nguyendochienthang711-ai/Robot_Teo_AI_mini/cad_3d_stl/backup_v9/teo_than_duoi.stl

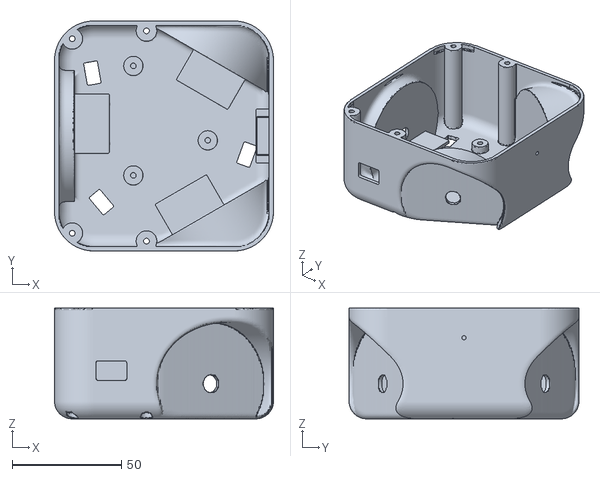
[picture p1: CAD file, 2026-11-09]
cad_3d_stl/backup_v9/teo_than_duoi.stl
100.0 x 105.0 x 50.5
