nguyendochienthang711-ai/Robot_Teo_AI_mini/cad_3d_stl/step/teo_mu_dau.step

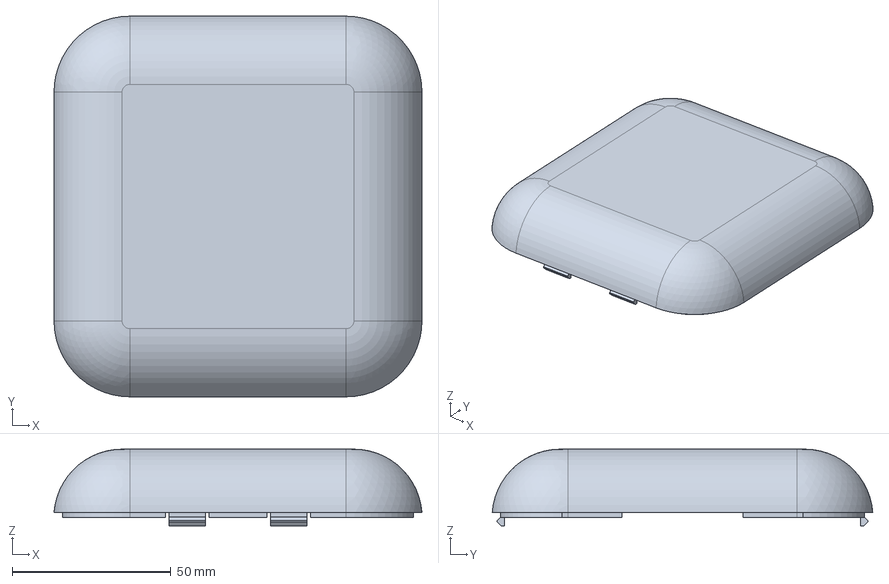
[picture p2: CAD file, 2026-11-14]
cad_3d_stl/step/teo_mu_dau.step
115.9 x 119.9 x 24.2 mm
