nguyendochienthang711-ai/Robot_Teo_AI_mini/cad_3d_stl/teo_tong_the_orca.3mf

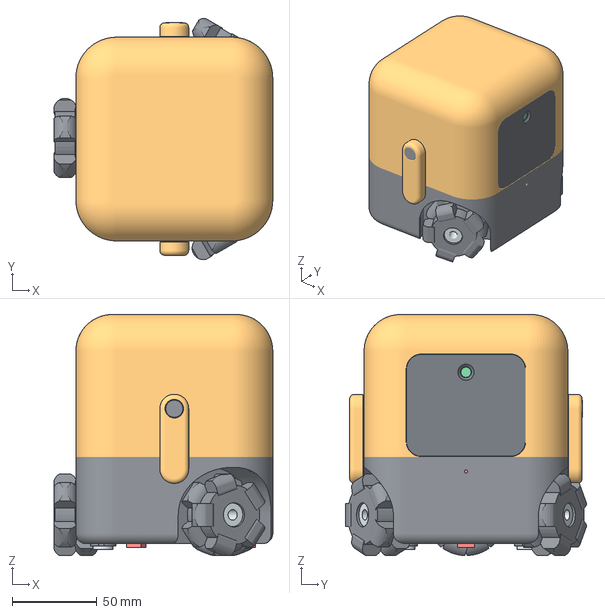
[picture p3: CAD file, 2026-11-14]
cad_3d_stl/teo_tong_the_orca.3mf
128.8 x 142.2 x 142.0 mm
