nguyendochienthang711-ai/Robot_Teo_AI_mini/cad_3d_stl/backup_v9/teo_kinh_sla.stl

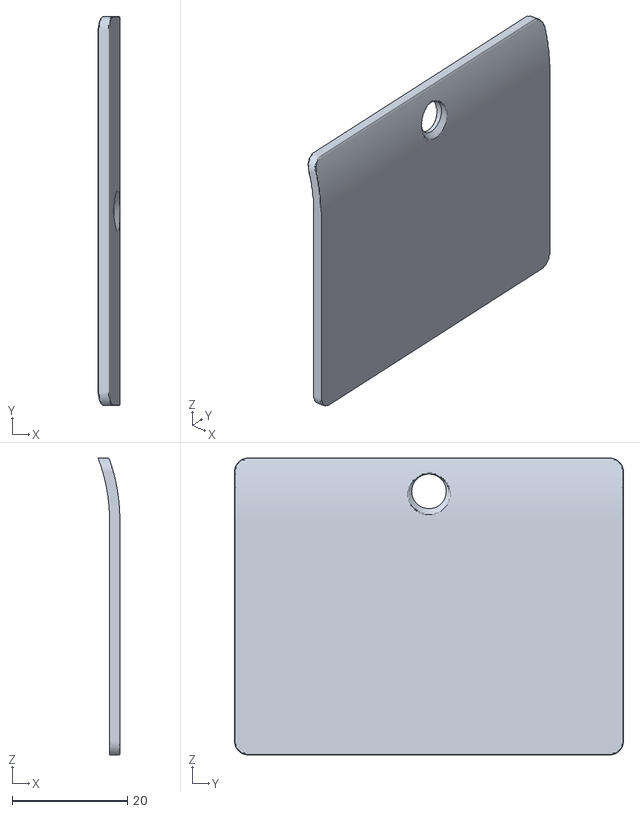
[picture p4: CAD file, 2026-11-09]
cad_3d_stl/backup_v9/teo_kinh_sla.stl
3.78 x 67.6 x 51.6
