nguyendochienthang711-ai/Robot_Teo_AI_mini/cad_3d_stl/step/teo_than_duoi.step

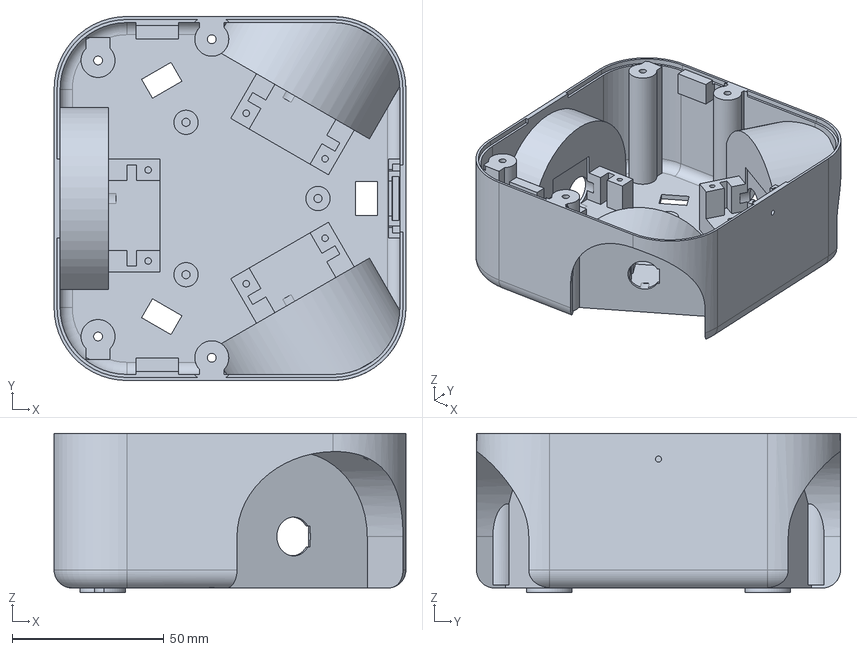
[picture p5: CAD file, 2026-11-14]
cad_3d_stl/step/teo_than_duoi.step
116.0 x 120.0 x 52.5 mm
