nguyendochienthang711-ai/Robot_Teo_AI_mini/cad_3d_stl/teo_tong_the_xuyen_thau_orca.3mf

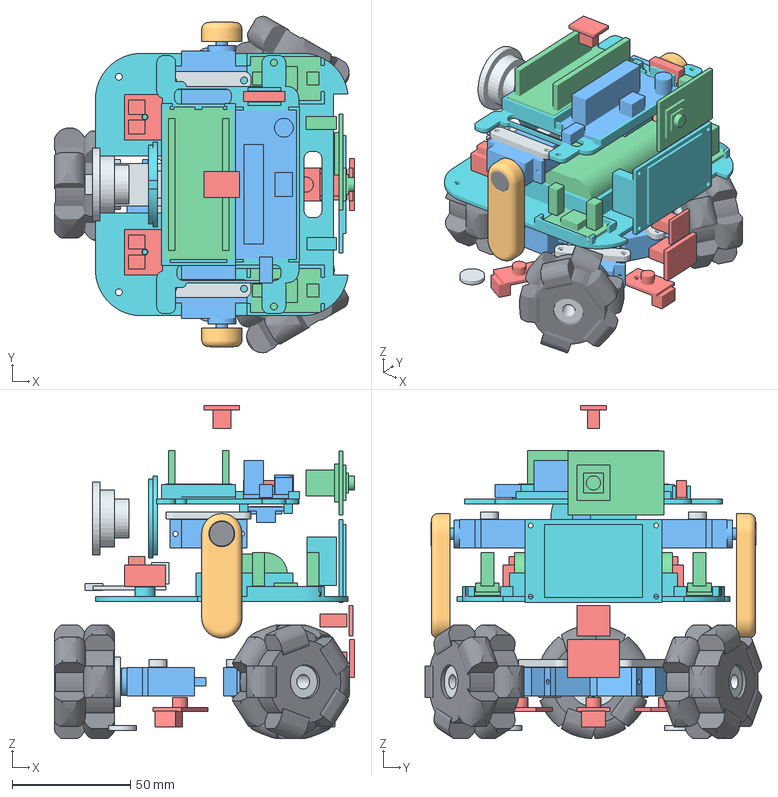
[picture p6: CAD file, 2026-11-14]
cad_3d_stl/teo_tong_the_xuyen_thau_orca.3mf
126.8 x 142.2 x 140.7 mm
