nguyendochienthang711-ai/Robot_Teo_AI_mini/cad_3d_stl/backup_v9/teo_vach_ngan.stl

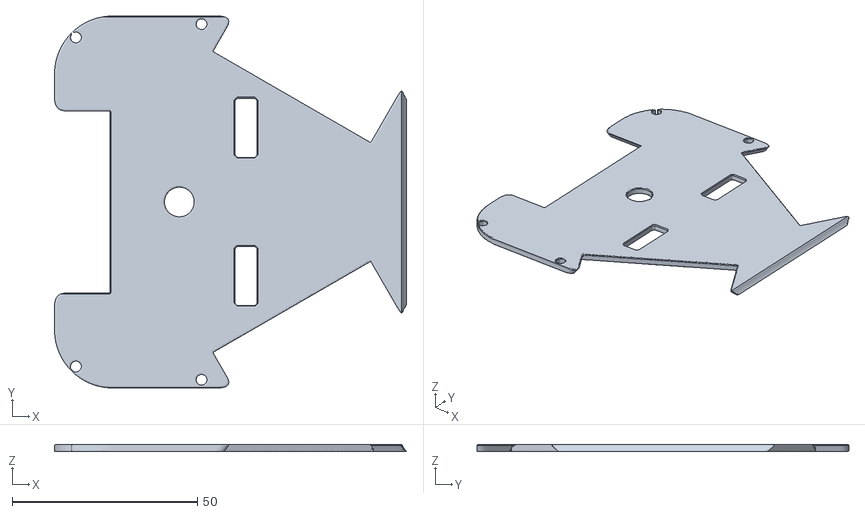
[picture p7: CAD file, 2026-11-09]
cad_3d_stl/backup_v9/teo_vach_ngan.stl
95.0 x 100.4 x 2.00
