nguyendochienthang711-ai/Robot_Teo_AI_mini/cad_3d_stl/step/teo_vach_ngan.step

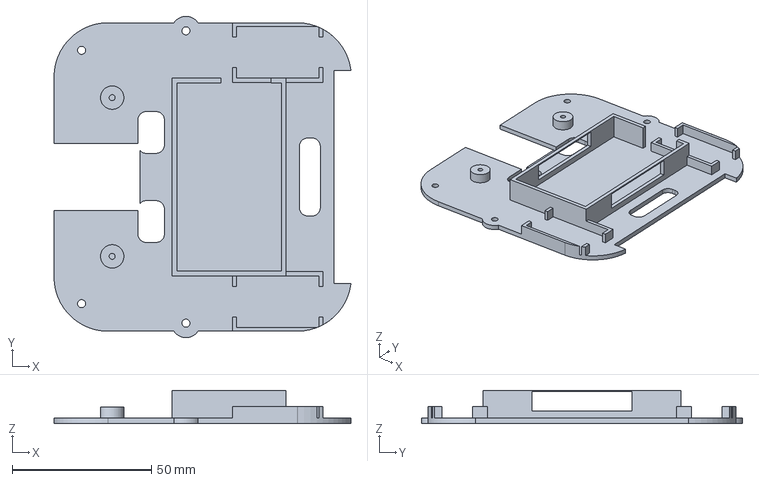
[picture p8: CAD file, 2026-11-14]
cad_3d_stl/step/teo_vach_ngan.step
106.7 x 115.4 x 12.0 mm
