nguyendochienthang711-ai/Robot_Teo_AI_mini/cad_3d_stl/backup_v9/teo_khay_linh_kien.stl

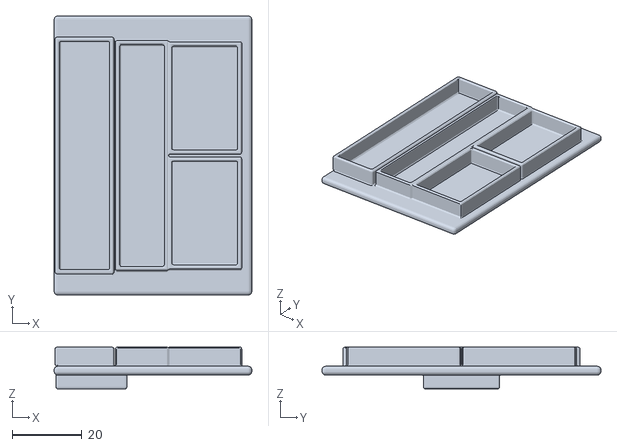
[picture p9: CAD file, 2026-11-09]
cad_3d_stl/backup_v9/teo_khay_linh_kien.stl
56.7 x 80.0 x 12.0
