nguyendochienthang711-ai/Robot_Teo_AI_mini/cad_3d_stl/step/teo_kinh_sla.step

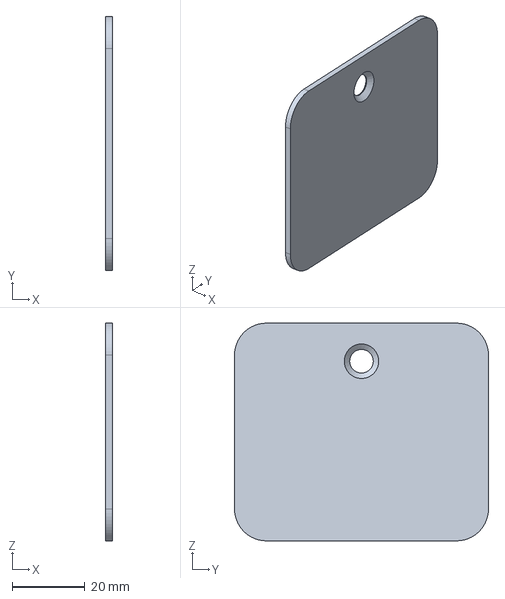
[picture p10: CAD file, 2026-11-14]
cad_3d_stl/step/teo_kinh_sla.step
1.80 x 70.0 x 60.0 mm
