nguyendochienthang711-ai/Robot_Teo_AI_mini/cad_3d_stl/backup_v9/teo_than_tren.stl

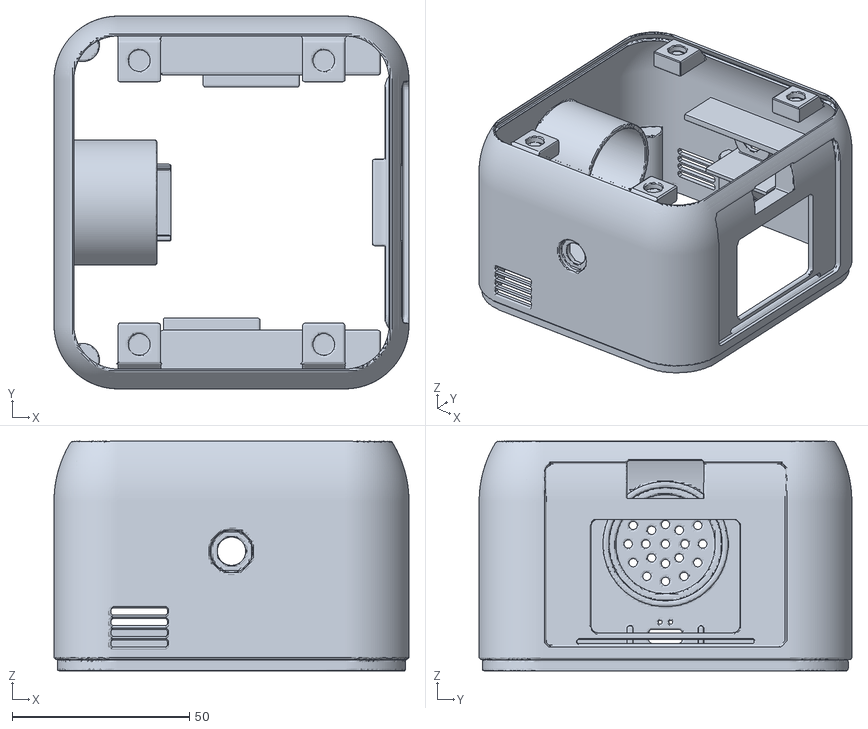
[picture p11: CAD file, 2026-11-09]
cad_3d_stl/backup_v9/teo_than_tren.stl
100.0 x 105.0 x 64.7
