nguyendochienthang711-ai/Robot_Teo_AI_mini/cad_3d_stl/step/teo_tay_robot.step

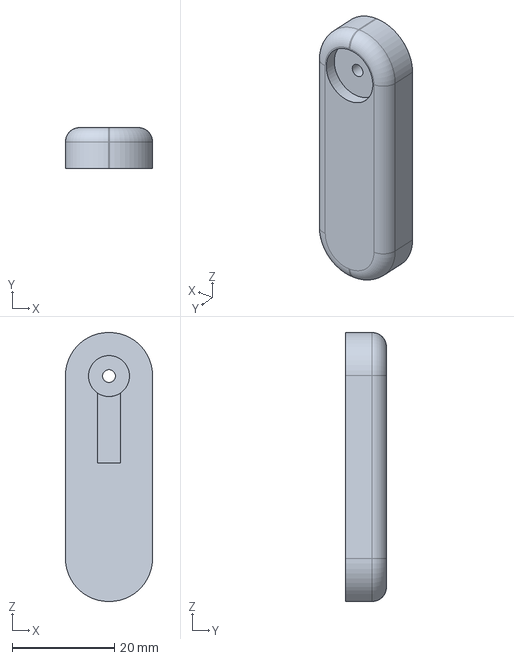
[picture p12: CAD file, 2026-11-14]
cad_3d_stl/step/teo_tay_robot.step
17.0 x 8.00 x 52.5 mm
