nguyendochienthang711-ai/Robot_Teo_AI_mini/cad_3d_stl/backup_v9/teo_nap_chup_tay.stl

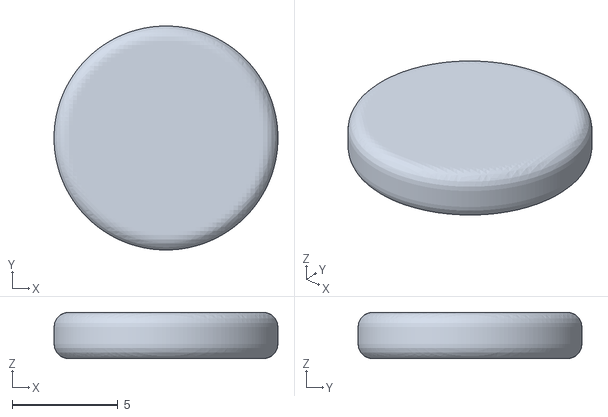
[picture p13: CAD file, 2026-11-09]
cad_3d_stl/backup_v9/teo_nap_chup_tay.stl
10.6 x 10.6 x 2.20
