nguyendochienthang711-ai/Robot_Teo_AI_mini/cad_3d_stl/step/teo_nep_giu_servo.step

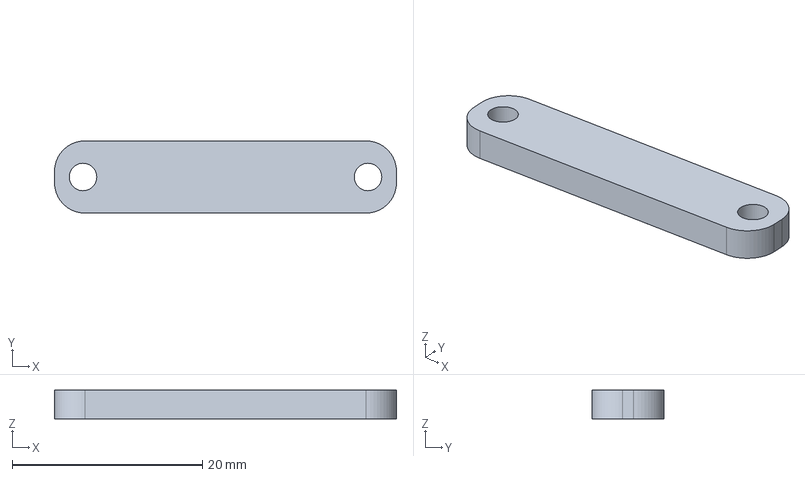
[picture p14: CAD file, 2026-11-14]
cad_3d_stl/step/teo_nep_giu_servo.step
36.0 x 7.60 x 3.00 mm
