nguyendochienthang711-ai/Robot_Teo_AI_mini/cad_3d_stl/backup_v9/teo_mu_dau.stl

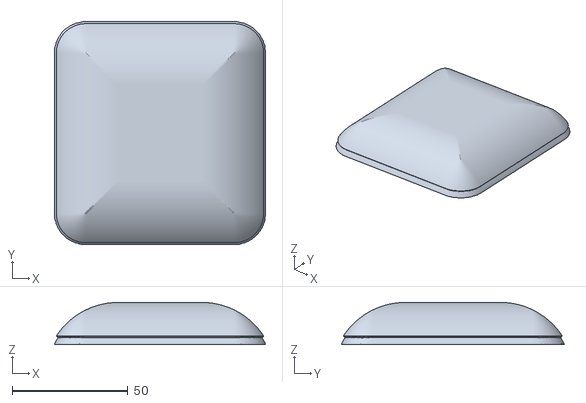
[picture p15: CAD file, 2026-11-09]
cad_3d_stl/backup_v9/teo_mu_dau.stl
91.2 x 96.3 x 18.2
