nguyendochienthang711-ai/Robot_Teo_AI_mini/cad_3d_stl/step/teo_nap_hop_loa.step

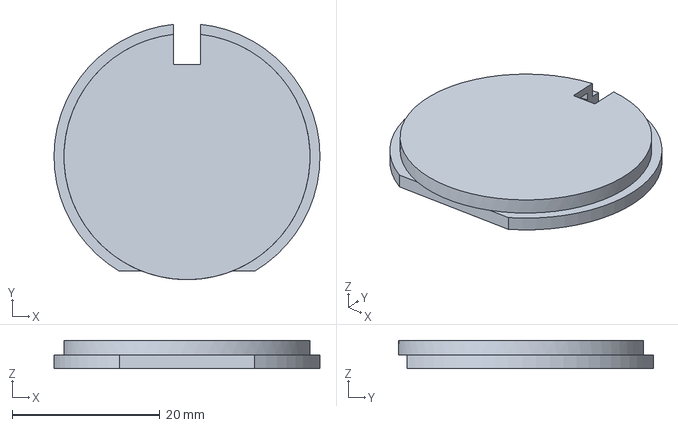
[picture p16: CAD file, 2026-11-14]
cad_3d_stl/step/teo_nap_hop_loa.step
36.0 x 34.6 x 3.80 mm
