nguyendochienthang711-ai/Robot_Teo_AI_mini/cad_3d_stl/backup_v9/teo_tay_robot.stl

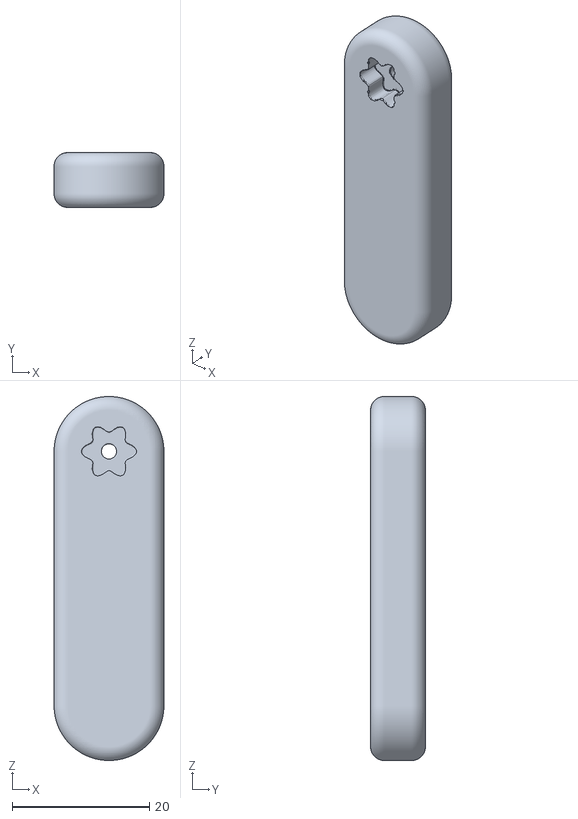
[picture p17: CAD file, 2026-11-09]
cad_3d_stl/backup_v9/teo_tay_robot.stl
16.0 x 8.00 x 53.0
