nguyendochienthang711-ai/Robot_Teo_AI_mini/cad_3d_stl/step/teo_khay_linh_kien.step

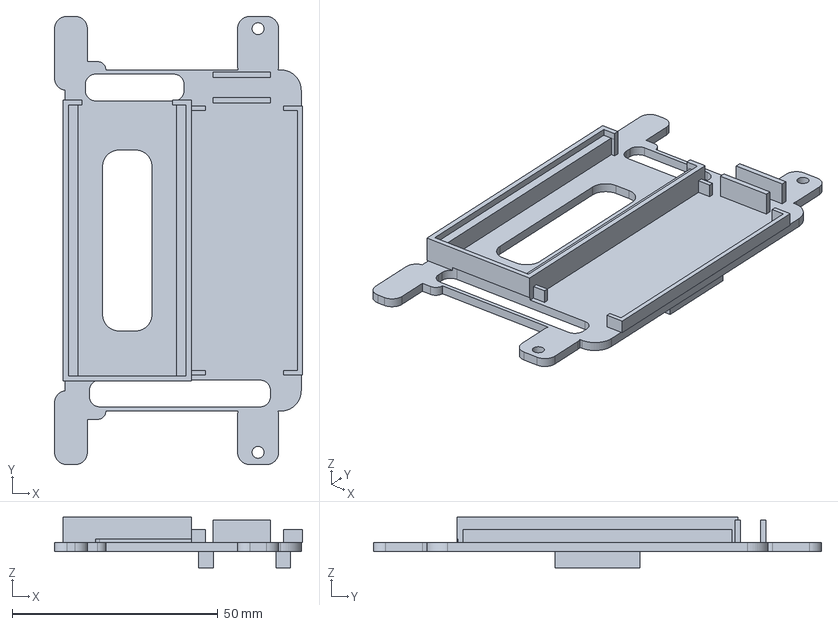
[picture p18: CAD file, 2026-11-14]
cad_3d_stl/step/teo_khay_linh_kien.step
60.3 x 109.0 x 12.4 mm
