nguyendochienthang711-ai/Robot_Teo_AI_mini/cad_3d_stl/step/teo_hub_banh_omni.step

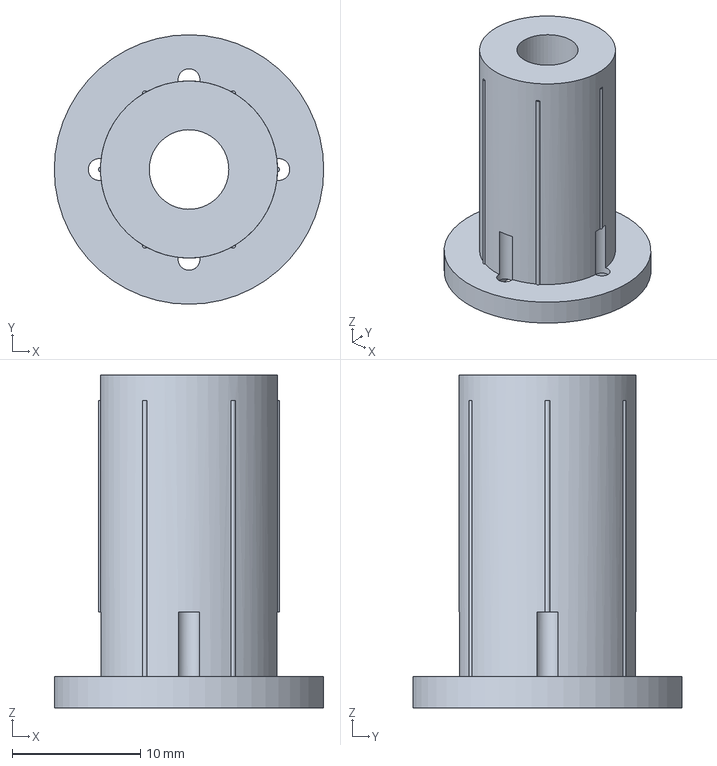
[picture p19: CAD file, 2026-11-14]
cad_3d_stl/step/teo_hub_banh_omni.step
21.0 x 21.0 x 25.9 mm
