nguyendochienthang711-ai/Robot_Teo_AI_mini/cad_3d_stl/step/teo_tong_the_cad_v10.step

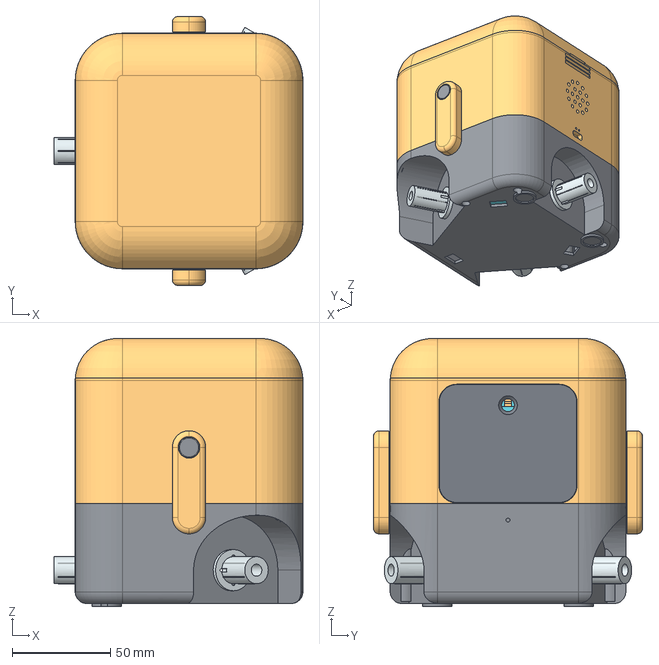
[picture p20: CAD file, 2026-11-14]
cad_3d_stl/step/teo_tong_the_cad_v10.step
126.8 x 137.2 x 136.5 mm
