nguyendochienthang711-ai/Robot_Teo_AI_mini/cad_3d_stl/step/teo_nap_chup_tay.step

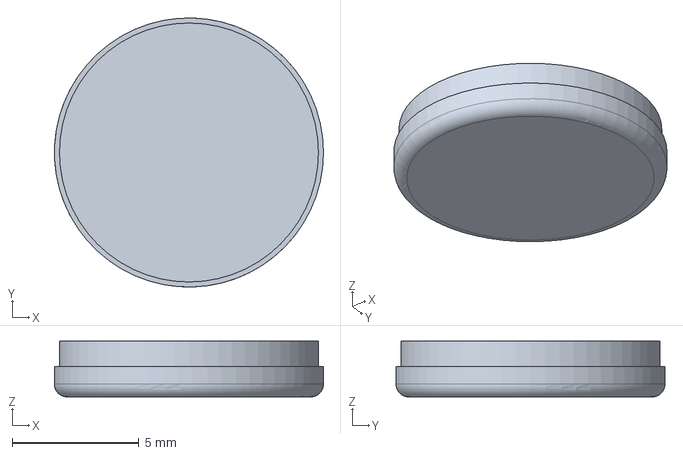
[picture p21: CAD file, 2026-11-14]
cad_3d_stl/step/teo_nap_chup_tay.step
10.6 x 10.6 x 2.20 mm
