nguyendochienthang711-ai/Robot_Teo_AI_mini/cad_3d_stl/step/teo_than_tren.step

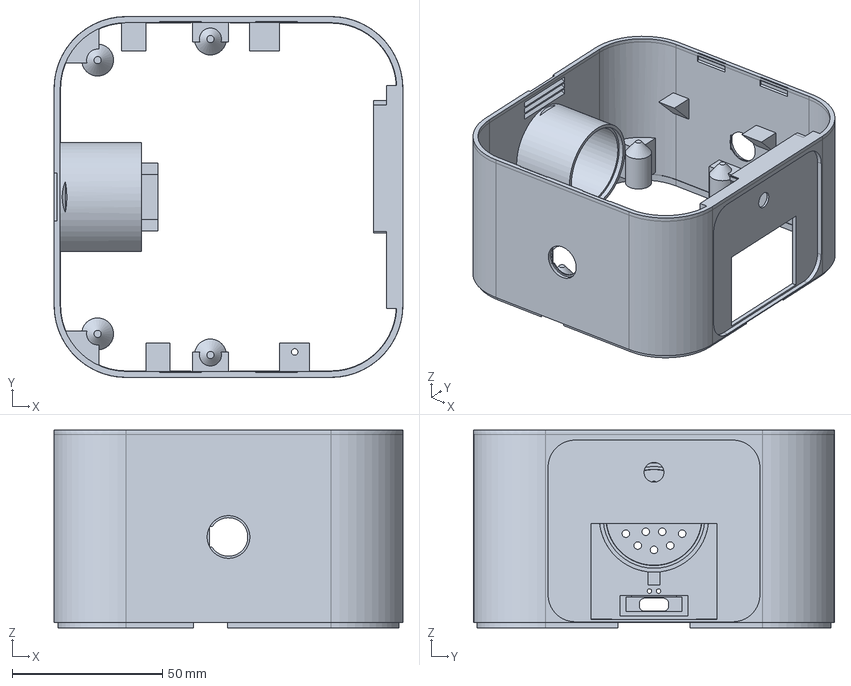
[picture p22: CAD file, 2026-11-14]
cad_3d_stl/step/teo_than_tren.step
116.0 x 120.0 x 65.7 mm
