nguyendochienthang711-ai/Robot_Teo_AI_mini/(list of files, cad)

Other CAD files:
cad_3d_stl/teo_hub_banh_omni.stl
cad_3d_stl/teo_khay_linh_kien.stl
cad_3d_stl/teo_kinh_sla.stl
cad_3d_stl/teo_mu_dau.stl
cad_3d_stl/teo_nap_chup_tay.stl
cad_3d_stl/teo_nap_hop_loa.stl
cad_3d_stl/teo_nep_giu_servo.stl
cad_3d_stl/teo_tay_robot.stl
cad_3d_stl/teo_than_duoi.stl
cad_3d_stl/teo_than_tren.stl
cad_3d_stl/teo_vach_ngan.stl
