nguyendochienthang711-ai/Robot_Teo_AI_mini/(commit log)

2026-11-02 Configure default Chipmunk voice (Mức 1, zero-reverb) with easy switching to Nam Trầm Điềm Đạm and Nam Trầm Vang
2026-11-03 Remove deprecated tools and aliases, upgrade to 3-wheel Omni Kiwi Drive navigation and motion bundles
2026-11-03 fix(core): wire async tool loop, transactional history, direct TTS commit, audio lock, and review fixes (R-01..R-26)
2026-11-03 fix(sim): resolve QACC numerical explosion using implicitfast integrator and stable actuator gains
2026-11-03 fix(sim): add anti-tip tail pad, lower CoM and rate-limit servo gestures to prevent tipping
2026-11-09 feat(cad): finalize CAD v10 unibody pod with zero collision, orcaslicer assemblies, and synchronized mujoco model
    - Parametric CAD generator (build_teo_cad.py) generating 11 watertight STEP/STL parts
    - Full 48-part assembly builder for OrcaSlicer (build_teo_assembly_orca.py) with solid and X-ray 3MFs
    - Custom 3D-printed MG90S to Nexus 14108 double-row omni wheel coupler hubs (R_wheel = 58mm)
    - Universal vertical screw clamps (zero-glue) for all 5 MG90S servos
    - ESP32-CAM OV3660 horizontal forehead mount and pin-up top electronics tray with full Dupont headroom
    - Sealed 3W speaker chamber with gasketed D-cut back cap and dual rear anti-tip pad seats
    - Synchronized MuJoCo model (teo_walle.xml)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
    [teo_hub_banh_omni.step, teo_hub_banh_omni.stl, teo_khay_linh_kien.step, teo_khay_linh_kien.stl, teo_kinh_sla.step, teo_kinh_sla.stl, teo_mu_dau.step, teo_mu_dau.stl]
2026-11-09 feat(harness): implement dual-layer agent runtime, eval suite, and workspace harness
    - Add TeoStateMachine with 6 AI states, ST7789 LCD eye sync, and LISTENING Omni wheel lock
    - Add TTP223 head touch confirmation for HITL and speech barge-in
    - Add PriorityAudioBus (Alert > Speech > Doc Reader) and Dynamic Context Builder
    - Add dual-mode evaluation harness (8 offline deterministic scenarios + live benchmark)
    - Add AI coding harness: .agents/hooks.json (10-turn gate), skills, and upgraded MCP tools
2026-11-14 feat(cad): update CAD v10 enclosure meshes, OrcaSlicer assemblies, and BOM
    [teo_hub_banh_omni.step, teo_khay_linh_kien.step, teo_kinh_sla.step, teo_mu_dau.step, teo_mu_dau.stl, teo_nap_chup_tay.step, teo_nap_hop_loa.step, teo_nep_giu_servo.step]
